LiBoard/LiBoard.github.io/index.md

---
title: Home
nav_order: 0
has_children: true
has_toc: false
---

# LiBoard
**A DIY electronic chessboard using photoresistors**

---

## Current features
* Track board position
* Save games as PGNs
* Play on Lichess

## Showcase
<iframe width="560" height="315" src="https://www.youtube.com/embed/BO89Nh89irY" title="YouTube video player" frameborder="0" allow="accelerometer; autoplay; clipboard-write; encrypted-media; gyroscope; picture-in-picture" allowfullscreen></iframe>

## Known problems
Please take a look at [Technical limitations](doc/how-it-works#technical-limitations)
and the open issues on the corresponding GitHub repositories before reporting a bug.

## Inspiration
* [https://youtu.be/uJqjMlebuHc](https://youtu.be/uJqjMlebuHc)

## License
This project is licensed under the GNU General Public License version 3.
