LiBoard/LiBoard.github.io/assets/images/hardware/board/board-bottom.jpg

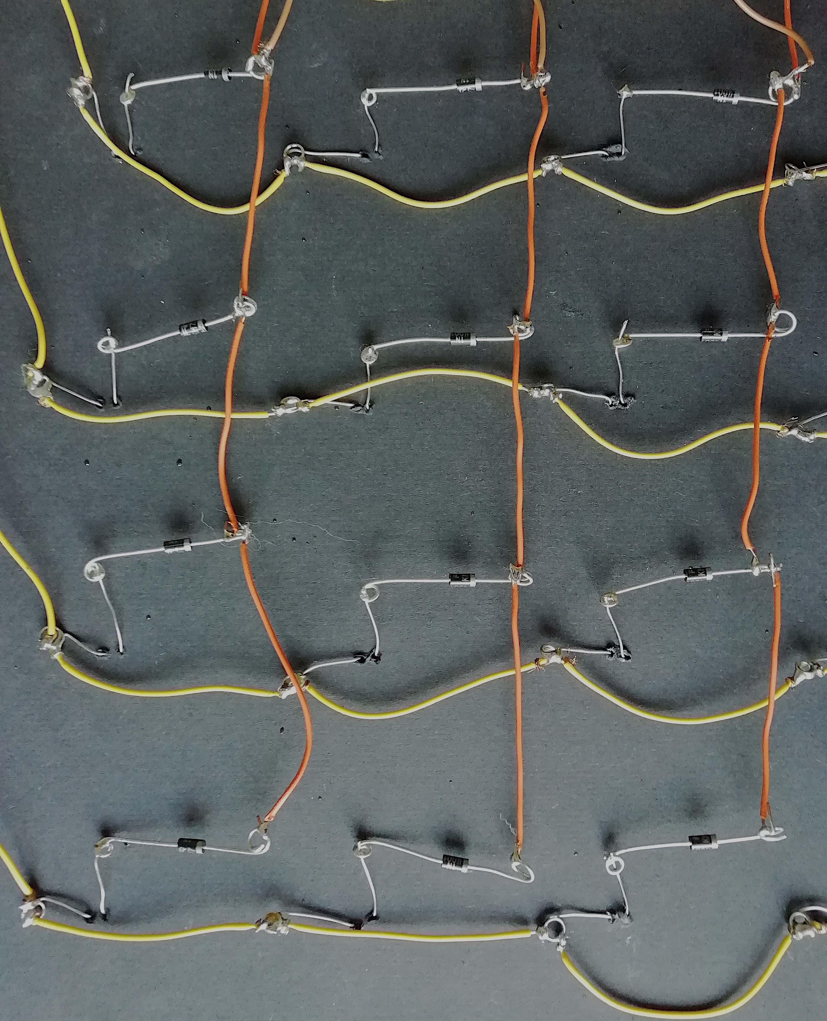
assets/images/hardware/board/board-bottom.jpg
