LiBoard/LiBoard.github.io/assets/images/hardware/board/board-top.jpg

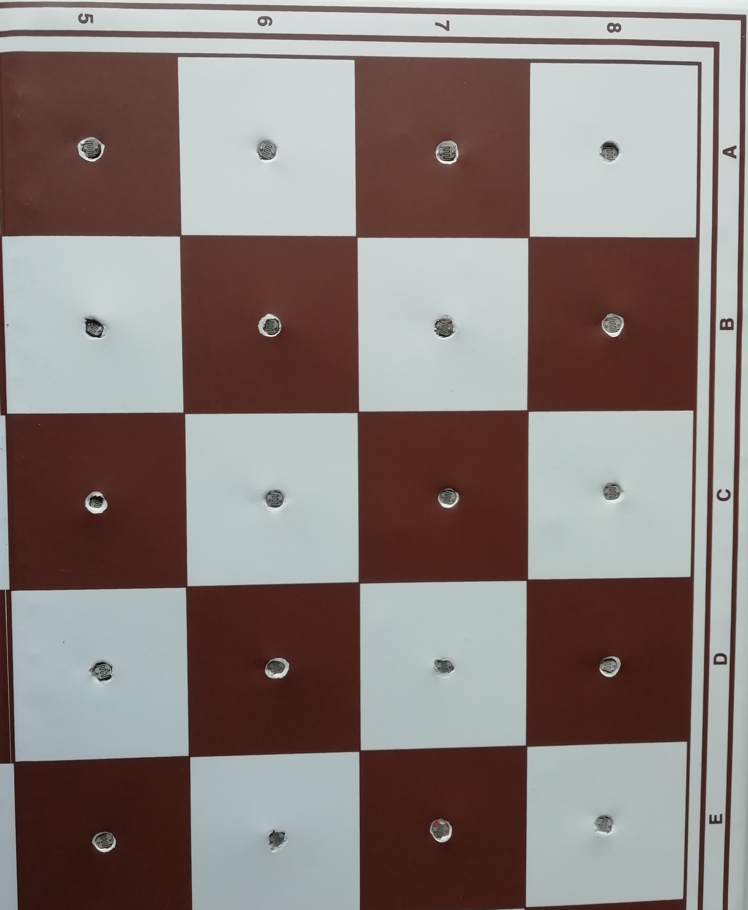
assets/images/hardware/board/board-top.jpg
