LiBoard/LiBoard.github.io/assets/images/hardware/board/bottom.jpg

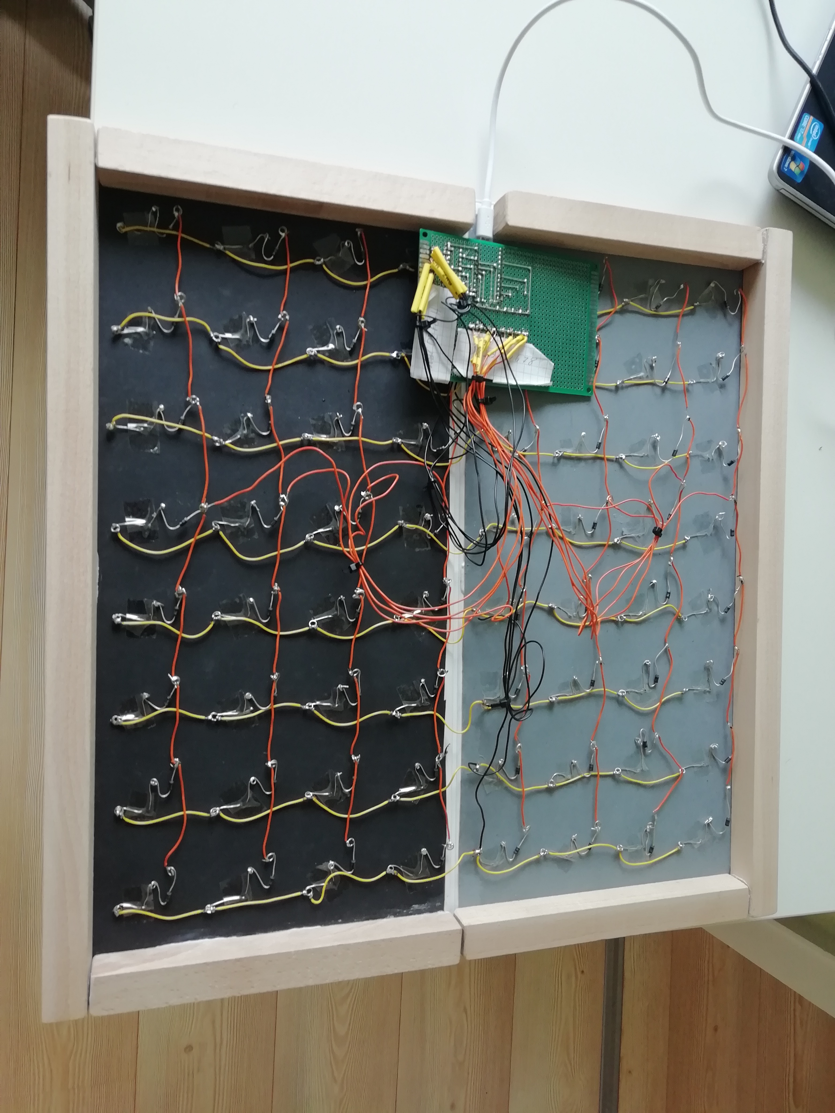
assets/images/hardware/board/bottom.jpg
