LiBoard/LiBoard.github.io/assets/images/hardware/board/top.jpg

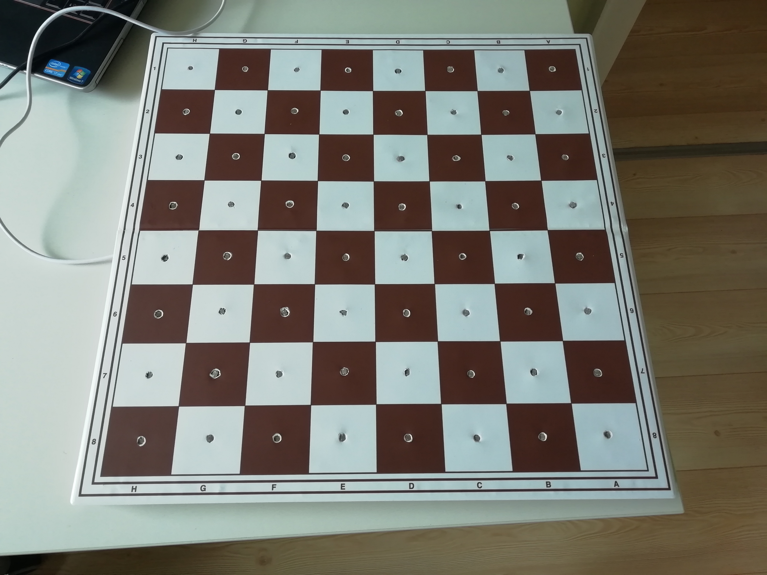
assets/images/hardware/board/top.jpg
