LiBoard/LiBoard.github.io/assets/images/hardware/circuit/circuit-bottom.jpg

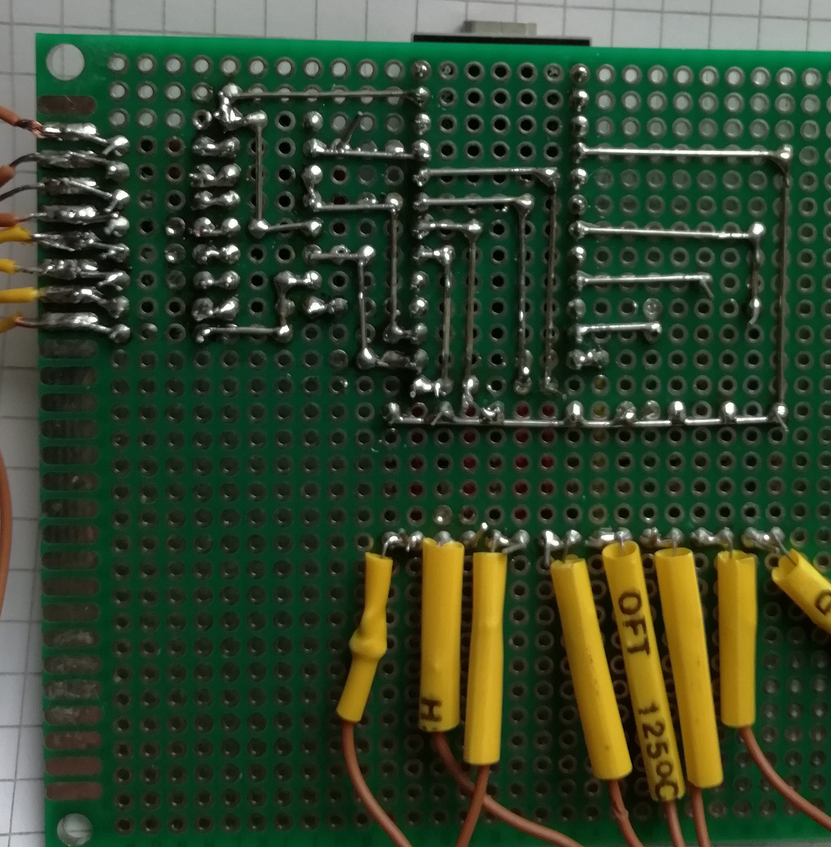
assets/images/hardware/circuit/circuit-bottom.jpg
