LiBoard/LiBoard.github.io/assets/images/hardware/circuit/circuit-top.jpg

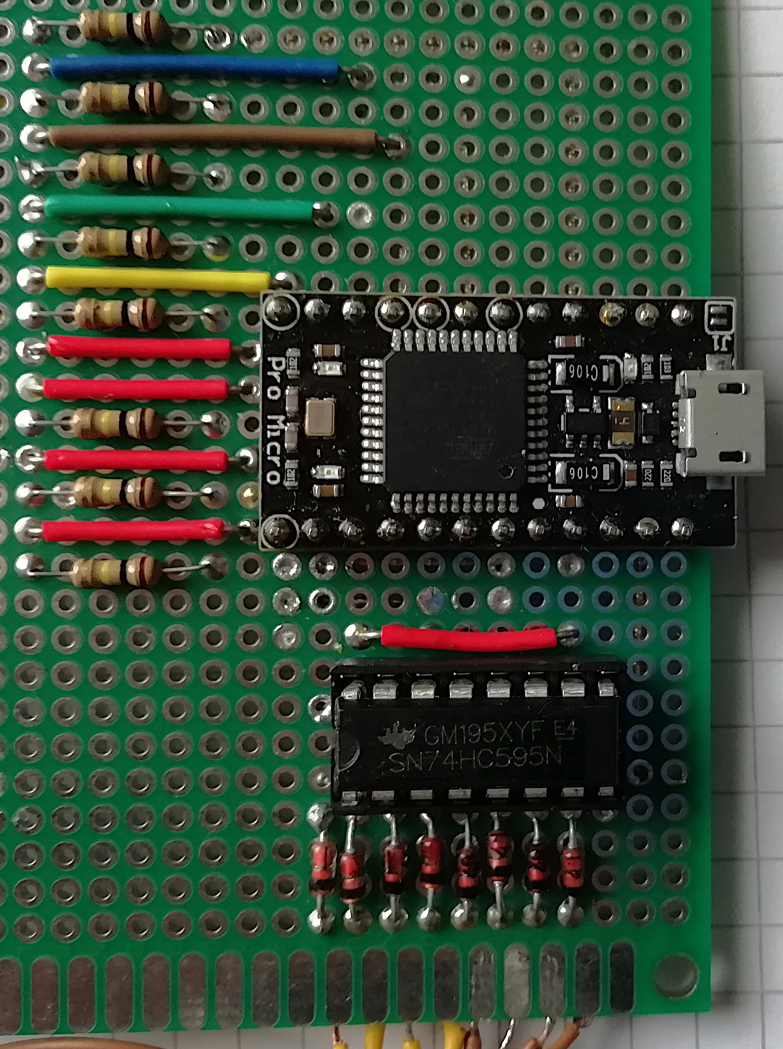
assets/images/hardware/circuit/circuit-top.jpg
