LiBoard/LiBoard.github.io/assets/images/hardware/circuit/circuit.jpg

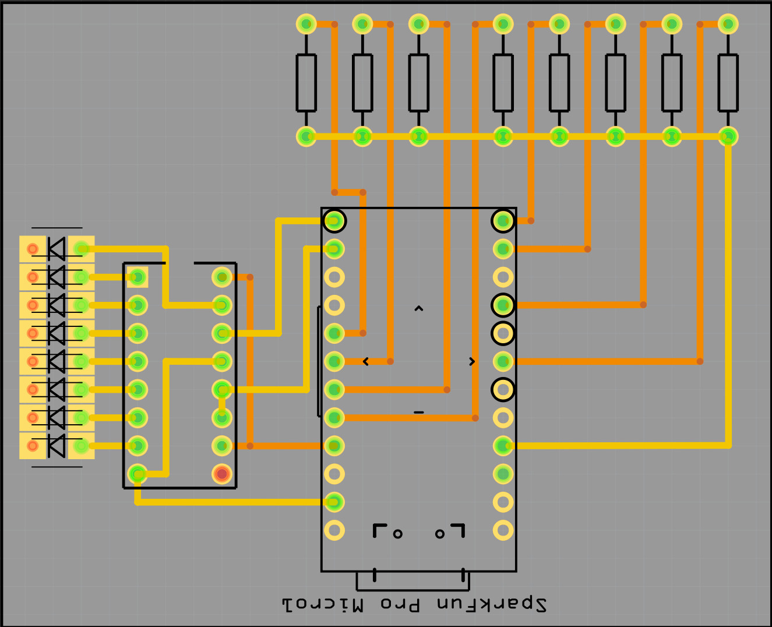
assets/images/hardware/circuit/circuit.jpg
