LiBoard/LiBoard.github.io/(list of files, drawings)

Other design files:
assets/download/liboard.fzz
