LiBoard/LiBoard.github.io/faq.md

---
title: FAQ
parent: Home
---
# FAQ
## What does the "Li" in LiBoard mean?
It was intended to mean "libre", but as the board uses light sensors, feel free to interpret it as "light" instead.
