LiBoard/LiBoard.github.io/doc/faq.md

---
title: FAQ
parent: Home
---
# {{ page.title }}
## What does the "Li" in LiBoard mean?
It was intended to mean "libre", but as the board uses light sensors, feel free to interpret it as "light" instead.

## How does it work?
See [How it works](how-it-works)
