LiBoard/LiBoard.github.io/(threads)

Thread 1 (2022-03-02):

Etched PCB

PhilLecl, 2022-03-02:
I'm planning to design and etch a PCB to replace the sloppily soldered one I'm currently using. It would also simplify making additional boards.

Thread 2 (2022-03-02):

3D printed frame

PhilLecl, 2022-03-02:
I'm planning to make a 3D printed frame that can be placed under the board and hold all the components.
Ideally, it would render soldering under the board unnecessary.
