LiBoard/LiBoard.github.io/(commit log)

2021-08-10 Add image gallery
    [liboard.fzz]
2021-08-10 Add arduino documentation
2021-08-10 Add Usage to arduino doc
2021-08-10 Add link to arduino doc
2021-09-07 Add app download button
